Willlum/Linear-CCD-with-LTSpice-KiCAD-Firmware-and-Python-Library/TCD1304Rev2KiCAD/TCD1304Rev2.step

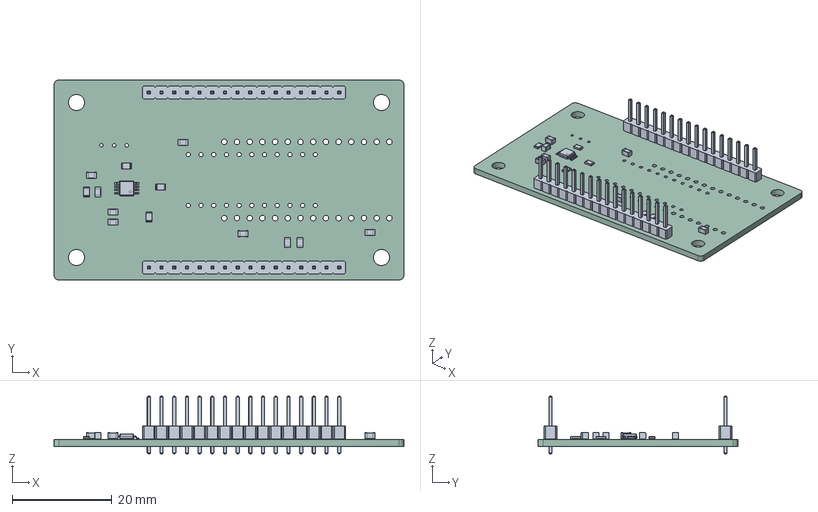
[picture p1: CAD file, 2026-01-20]
TCD1304Rev2KiCAD/TCD1304Rev2.step
70.0 x 40.0 x 11.5 mm
R_0805_2012Metric x 6
C_0805_2012Metric x 7
MSOP-8_3x3mm_P0.65mm
PinHeader_1x16_P2.54mm_Vertical x 2
TCD1304Rev2_PCB
