Willlum/Linear-CCD-with-LTSpice-KiCAD-Firmware-and-Python-Library/TCD1304Rev2KiCAD/TCD1304Rev2.kicad_pcb

## KiCad design TCD1304Rev2KiCAD/TCD1304Rev2.kicad_pcb (2025-10-06)

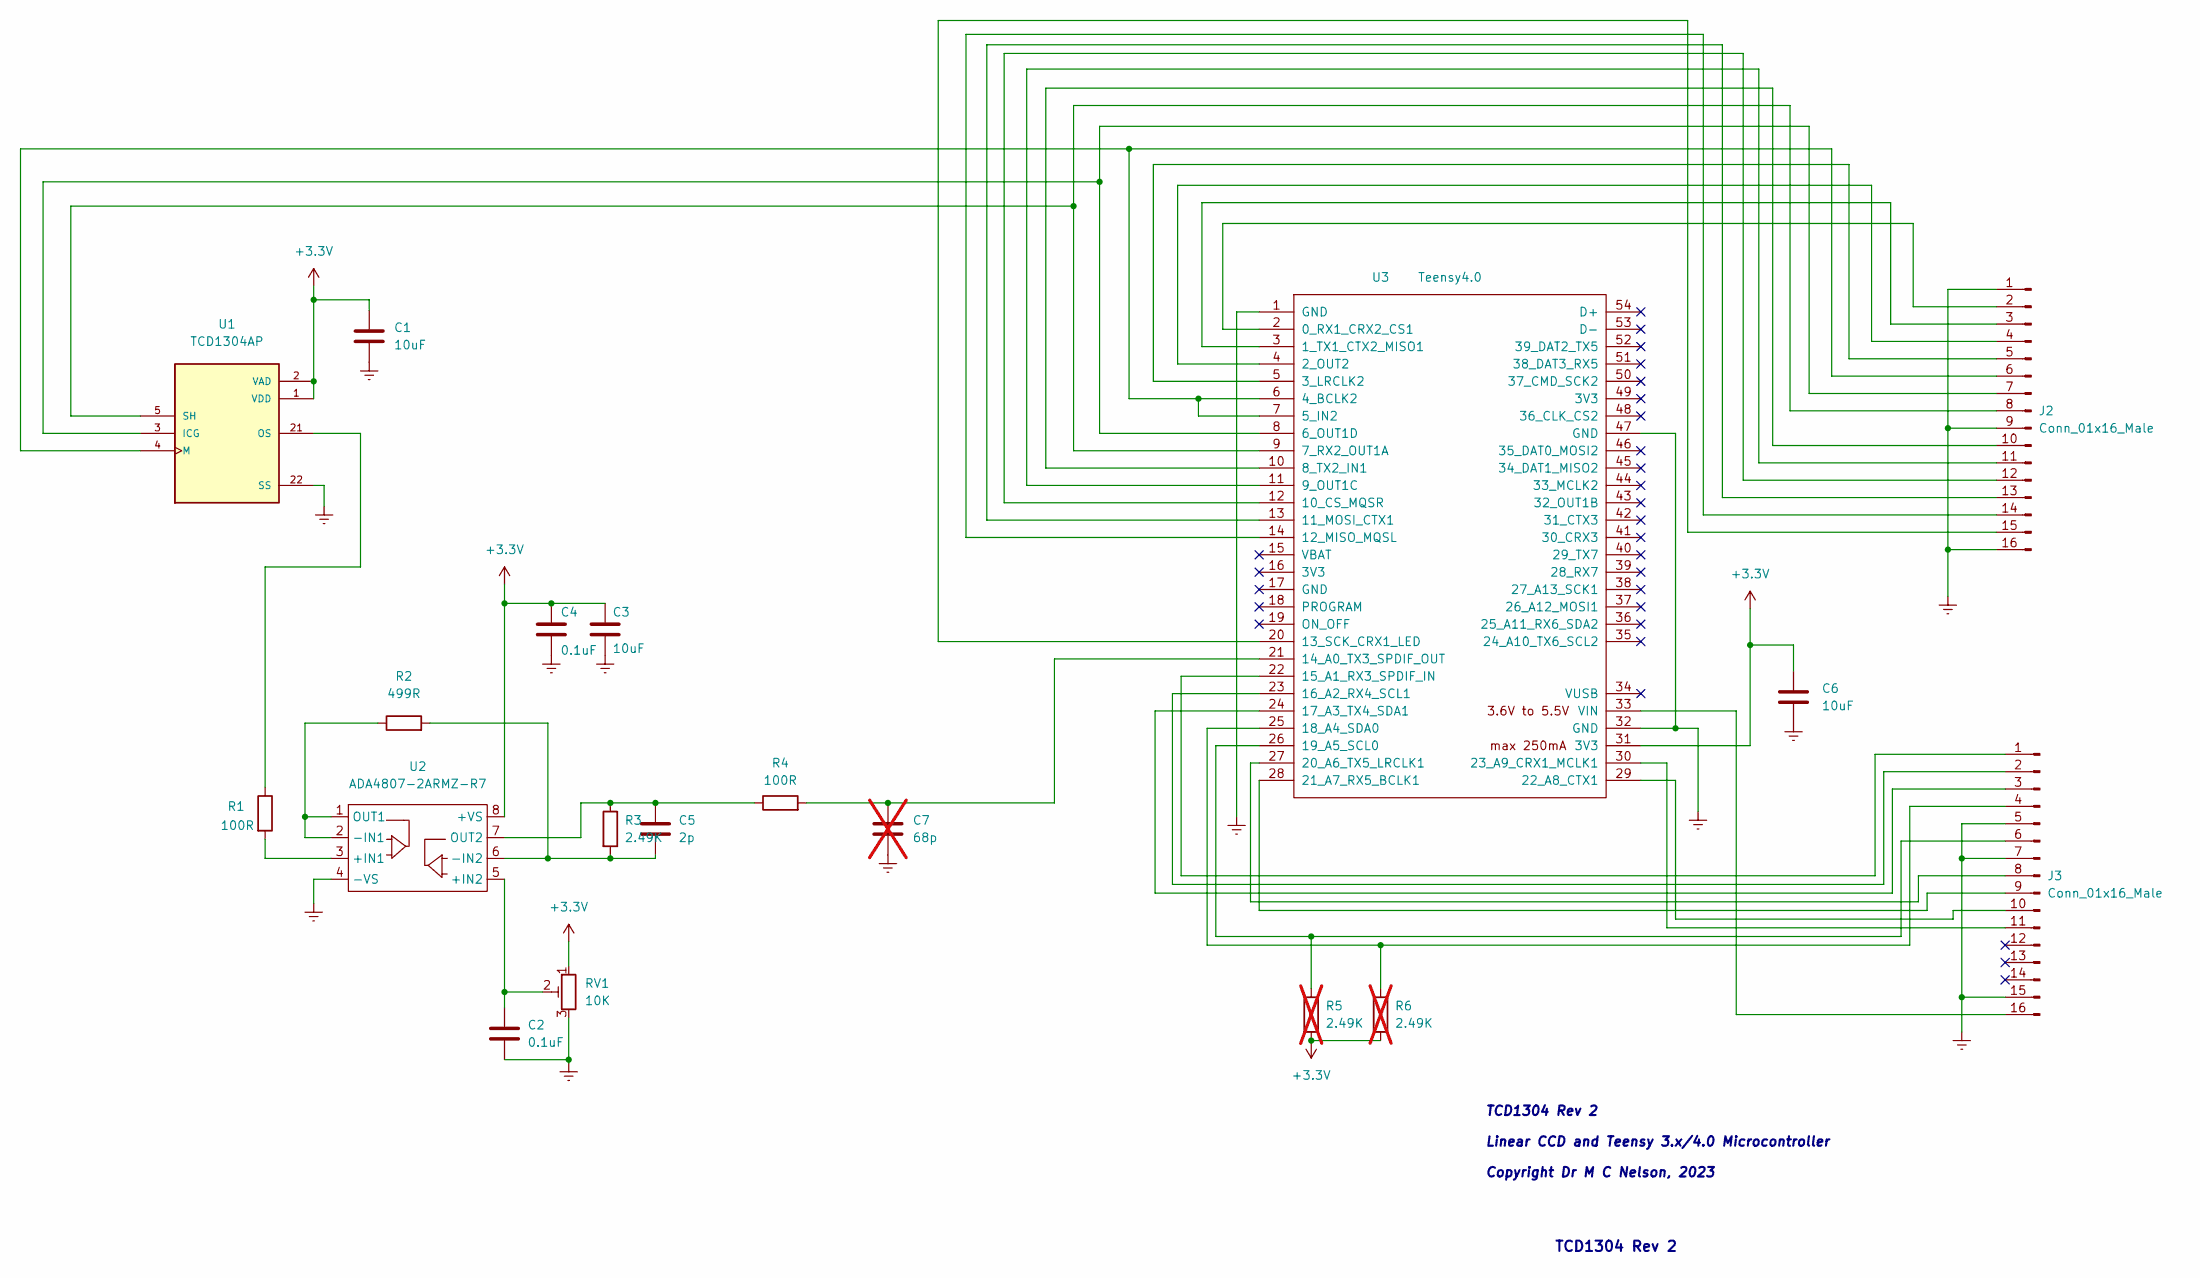
[picture p2: schematic TCD1304Rev2.kicad_sch]

Parts:
C1, C3, C6: 10uF; C_0805_2012Metric_Pad1.18x1.45mm_HandSolder; Digikey 490-12317-1-ND
C2, C4: 0.1uF; C_0805_2012Metric_Pad1.18x1.45mm_HandSolder; Digikey 399-C0603X104J3RACAUTOCT-ND
C5: 2p; C_0805_2012Metric_Pad1.18x1.45mm_HandSolder; Digikey 1284-1196-1-ND
C7: 68p; C_0805_2012Metric_Pad1.18x1.45mm_HandSolder; Digikey 1276-1135-1-ND; not fitted
J2, J3: Conn_01x16_Male; PinHeader_1x16_P2.54mm_Vertical; Digikey 3M156268-16-ND
R1, R4: 100R; R_0805_2012Metric_Pad1.20x1.40mm_HandSolder; Digikey 2019-RK73H1JTTD1000FCT-ND
R2: 499R; R_0805_2012Metric_Pad1.20x1.40mm_HandSolder; Digikey 2019-RK73H1JTTD4990FCT-ND
R3: 2.49K; R_0805_2012Metric_Pad1.20x1.40mm_HandSolder; Digikey 311-2.49KHRCT-ND
R5, R6: 2.49K; R_0805_2012Metric_Pad1.20x1.40mm_HandSolder; Digikey 311-2.49KHRCT-ND; not fitted
RV1: 10K; TRIM_3296W-1-502LF; Digikey 3296W-103LF-ND
U1: TCD1304AP; DIP1016W47P254L4210H372Q22; Digikey 110-87-422-41-001101
U2: ADA4807-2ARMZ-R7; MSOP-8_3x3mm_P0.65mm; Digikey ADA4807-2ARMZ-R7CT-ND
U3: Teensy4.0; Teensy40; Digikey 1568-DEV-16997-ND

Connections:
+3.3V: C1.1, C3.1, C4.1, C6.1, R5.2, R6.2, RV1.1, U1.1 (VDD), U1.2 (VAD), U2.8 (+VS), U3.31 (3V3)
Earth: C1.2, C2.2, C3.2, C4.2, C6.2, C7.2, J2.1, J2.9, J2.16, J3.5, J3.7, J3.15, RV1.3, U1.22 (SS), U2.4 (-VS), U3.1 (GND), U3.32 (GND), U3.47 (GND)
unnamed: J2.2, U3.2 (0_RX1_CRX2_CS1)
unnamed: J2.3, U3.3 (1_TX1_CTX2_MISO1)
unnamed: J2.4, U3.4 (2_OUT2)
unnamed: J2.5, U3.5 (3_LRCLK2)
unnamed: J2.6, U1.4 (M), U3.6 (4_BCLK2), U3.7 (5_IN2)
unnamed: J2.7, U1.3 (ICG), U3.8 (6_OUT1D)
unnamed: J2.8, U1.5 (SH), U3.9 (7_RX2_OUT1A)
unnamed: J2.10, U3.10 (8_TX2_IN1)
unnamed: J2.11, U3.11 (9_OUT1C)
unnamed: J2.12, U3.12 (10_CS_MQSR)
unnamed: J2.13, U3.13 (11_MOSI_CTX1)
unnamed: J2.14, U3.14 (12_MISO_MQSL)
unnamed: J2.15, U3.20 (13_SCK_CRX1_LED)
unnamed: J3.1, U3.22 (15_A1_RX3_SPDIF_IN)
unnamed: J3.2, U3.23 (16_A2_RX4_SCL1)
unnamed: J3.3, U3.24 (17_A3_TX4_SDA1)
unnamed: J3.4, R6.1, U3.25 (18_A4_SDA0)
unnamed: J3.6, R5.1, U3.26 (19_A5_SCL0)
unnamed: J3.8, U3.27 (20_A6_TX5_LRCLK1)
unnamed: J3.9, U3.28 (21_A7_RX5_BCLK1)
unnamed: J3.10, U3.29 (22_A8_CTX1)
unnamed: J3.11, U3.30 (23_A9_CRX1_MCLK1)
unnamed: J3.16, U3.33 (VIN)
unnamed: R1.1, U1.21 (OS)
unnamed: R1.2, U2.3 (+IN1)
unnamed: C2.1, RV1.2, U2.5 (+IN2)
unnamed: R2.1, U2.1 (OUT1), U2.2 (-IN1)
unnamed: C5.2, R2.2, R3.2, U2.6 (-IN2)
unnamed: C5.1, R3.1, R4.1, U2.7 (OUT2)
unnamed: C7.1, R4.2, U3.21 (14_A0_TX3_SPDIF_OUT)

Notes on the sheet:
TCD1304 Rev 2 Linear CCD and Teensy 3.x/4.0 Microcontroller Copyright Dr M C Nelson, 2023
TCD1304 Rev 2

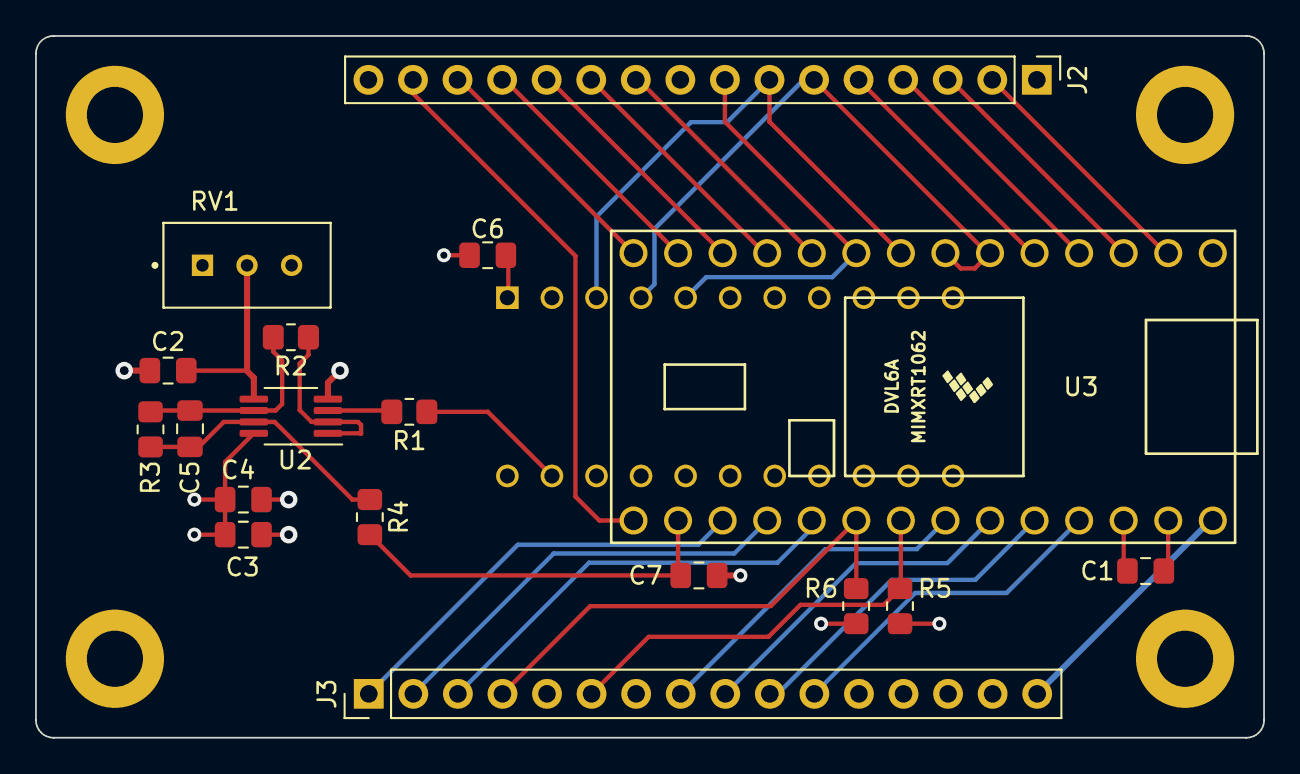
[picture p3: board TCD1304Rev2.kicad_pcb from above]

Board: 4 copper layers, 70.0 x 40.0 mm, 19 parts (1 on the bottom side), 32 nets.
