Willlum/Linear-CCD-with-LTSpice-KiCAD-Firmware-and-Python-Library/(commit log)

2025-10-06 updated pcb
    [TCD1304Rev2-B_Cu.gbr, TCD1304Rev2-B_Mask.gbr, TCD1304Rev2-B_Paste.gbr, TCD1304Rev2-B_Silkscreen.gbr, TCD1304Rev2-Edge_Cuts.gbr, TCD1304Rev2-F_Cu.gbr, TCD1304Rev2-F_Mask.gbr, TCD1304Rev2-F_Paste.gbr]
2026-01-20 pcb changes
    [TCD1304Rev2.step]
2026-02-01 added data sheet for TCD sensor
